fl0m0/AA_Battery_Pack/doc/IBN_RevA.md

# Stücklistenänderungen

1. R5 = 20k
1. R1 = 20k

# Thermokamera

Tests mit 1800 mAh Lipo durchgeführt.

## Last

Vbat = 3,9 V

Last 500 mA und 700 mA

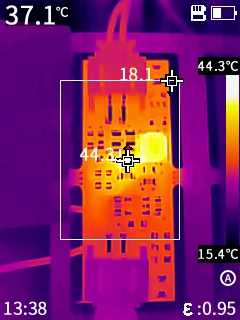
[picture p1: doc/thermal/IRI_20250215_133806.jpg]
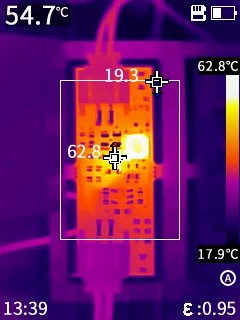
[picture p2: doc/thermal/IRI_20250215_133919.jpg]
 

## Ladebetrieb

Vbat = 3,9 V, R2 = 2k, Ladestrom 0,5 A

VBUS = 5 V, rechts mit zusätzlichem Laststrom 0,5 A

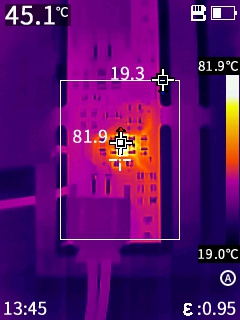
[picture p3: doc/thermal/IRI_20250215_134541.jpg]
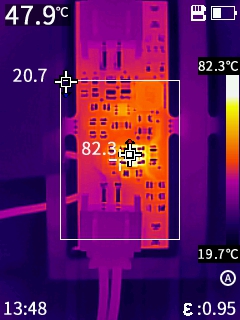
[picture p4: doc/thermal/IRI_20250215_134801.jpg]
  

---

Vbat = 3,9 V, **R2 = 2,2k**, Ladestrom 0,454 mA

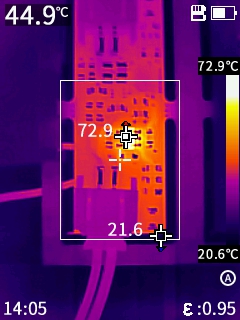
[picture p5: doc/thermal/IRI_20250215_140542.jpg]
 

---

Vbat = 3,9 V, **R2 = 3k**, Ladestrom 0,333 mA

VBUS = 5 V, rechts VBUS = 5,4 V

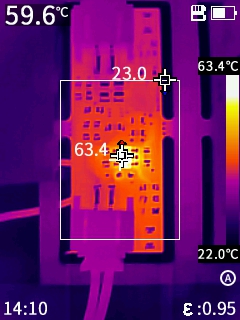
[picture p6: doc/thermal/IRI_20250215_141036.jpg]
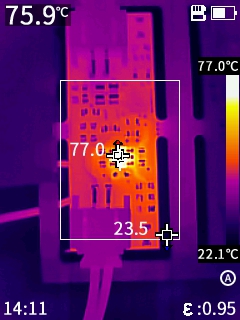
[picture p7: doc/thermal/IRI_20250215_141140.jpg]
 

---

# Verbrauch im Leerlauf

| Vbat (V) | Ibat (µA) | Low Bat LED |
| --- | --- | --- |
| 3,2 | 821 | an |
| 3,3 | 807 | an |
| 3,4 | 794 | an |
| 3,5 | 782 | an |
| 3,6 | 772 | an |
| 3,7 | 663 | aus |
| 3,8 | 649 | aus |
| 3,9 | 636 | aus |
| 4,0 | 623 | aus |
| 4,1 | 613 | aus |
| 4,2 | 601 | aus |
