fl0m0/AA_Battery_Pack/doc/thermal/VIS_20250215_134541.jpg

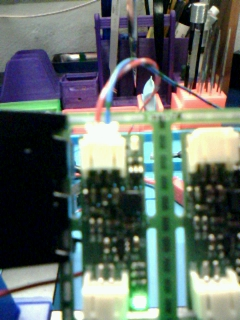
doc/thermal/VIS_20250215_134541.jpg
