fl0m0/AA_Battery_Pack/mech/Triple_AA.FCStd

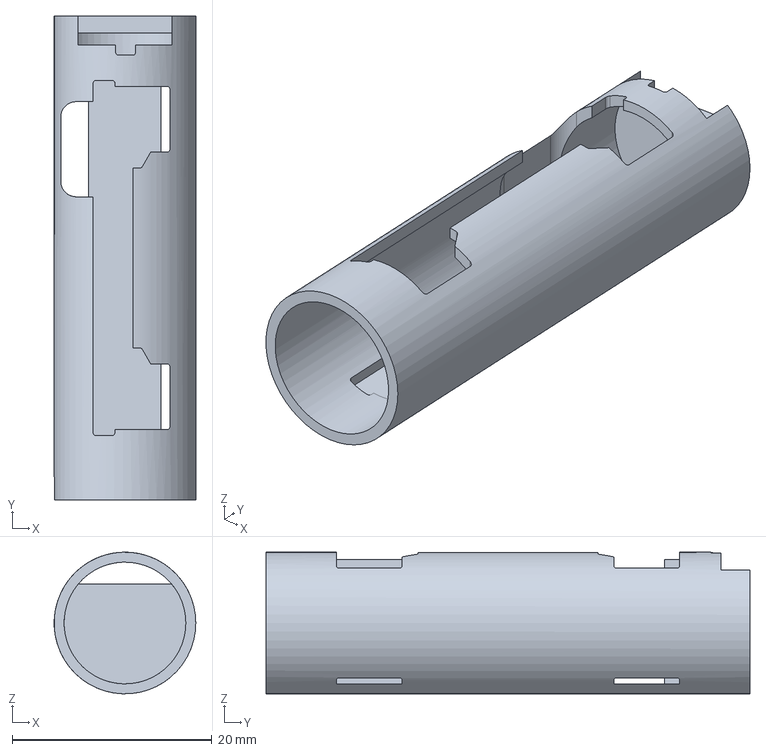
[picture p16: CAD file, 2025-02-15]
mech/Triple_AA.FCStd
14.2 x 48.5 x 14.2 mm
