fl0m0/AA_Battery_Pack/mech/Keystone_228.step

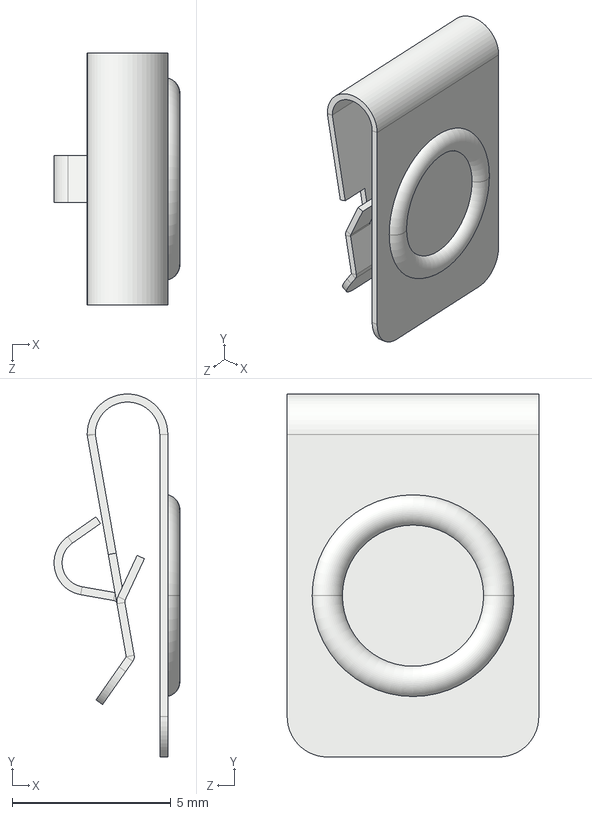
[picture p17: CAD file, 2025-02-15]
mech/Keystone_228.step
3.96 x 11.4 x 7.92 mm
