fl0m0/AA_Battery_Pack/mech/Keystone_209.step

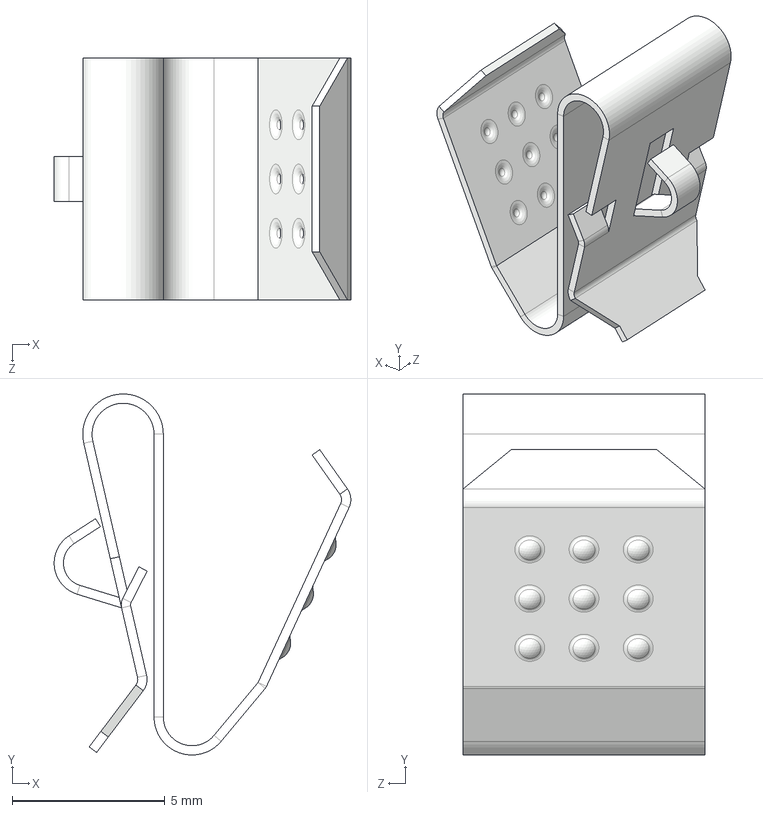
[picture p18: CAD file, 2025-02-15]
mech/Keystone_209.step
9.73 x 11.8 x 7.92 mm
