fl0m0/AA_Battery_Pack/mech/PCBA.FCStd

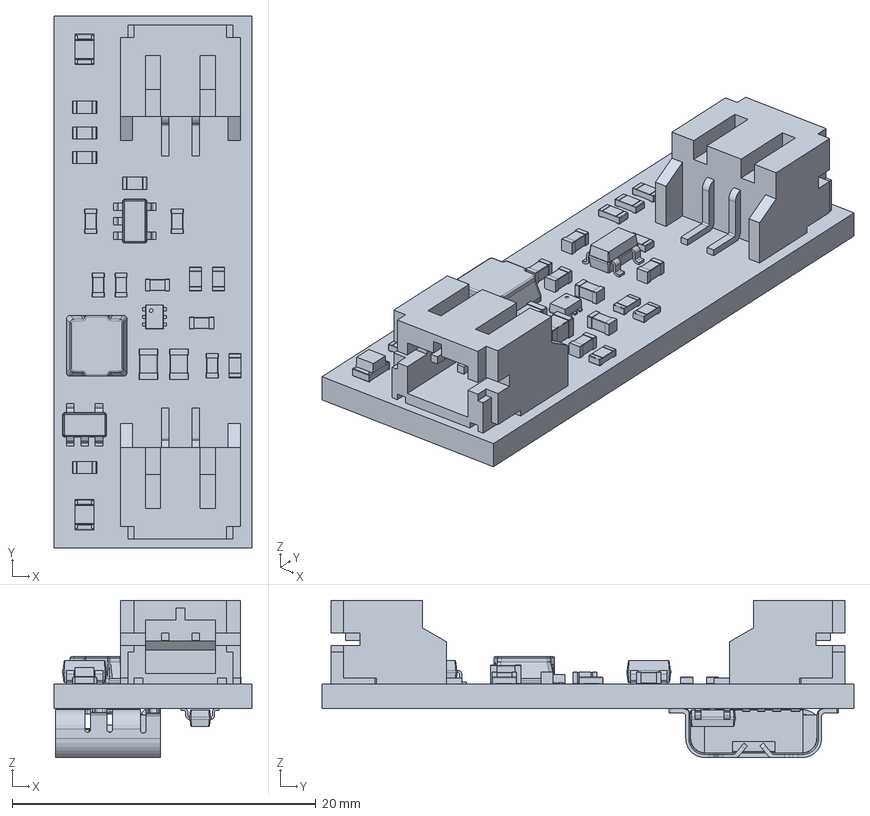
[picture p19: CAD file, 2025-02-15]
mech/PCBA.FCStd
13.0 x 35.0 x 10.3 mm
