fl0m0/AA_Battery_Pack/pcb/TripleAA/outputs/TripleAA_Rev_A.pdf

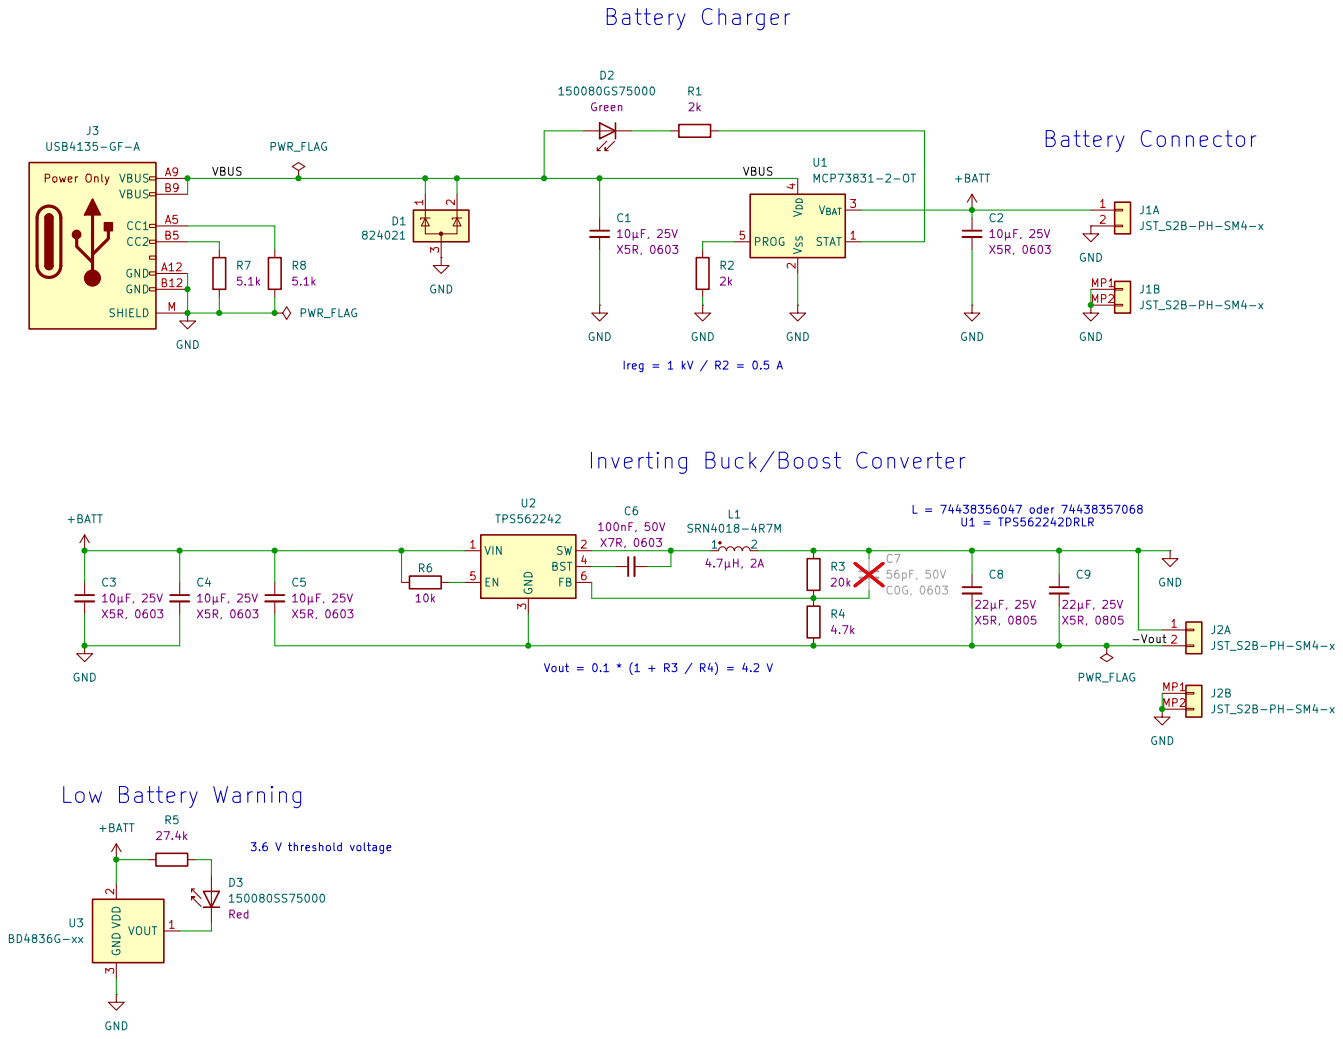
[picture p20: page 1]
