fl0m0/AA_Battery_Pack/pcb/TripleAA/TripleAA.kicad_pcb

## KiCad design pcb/TripleAA/TripleAA.kicad_pcb (2024-12-01)

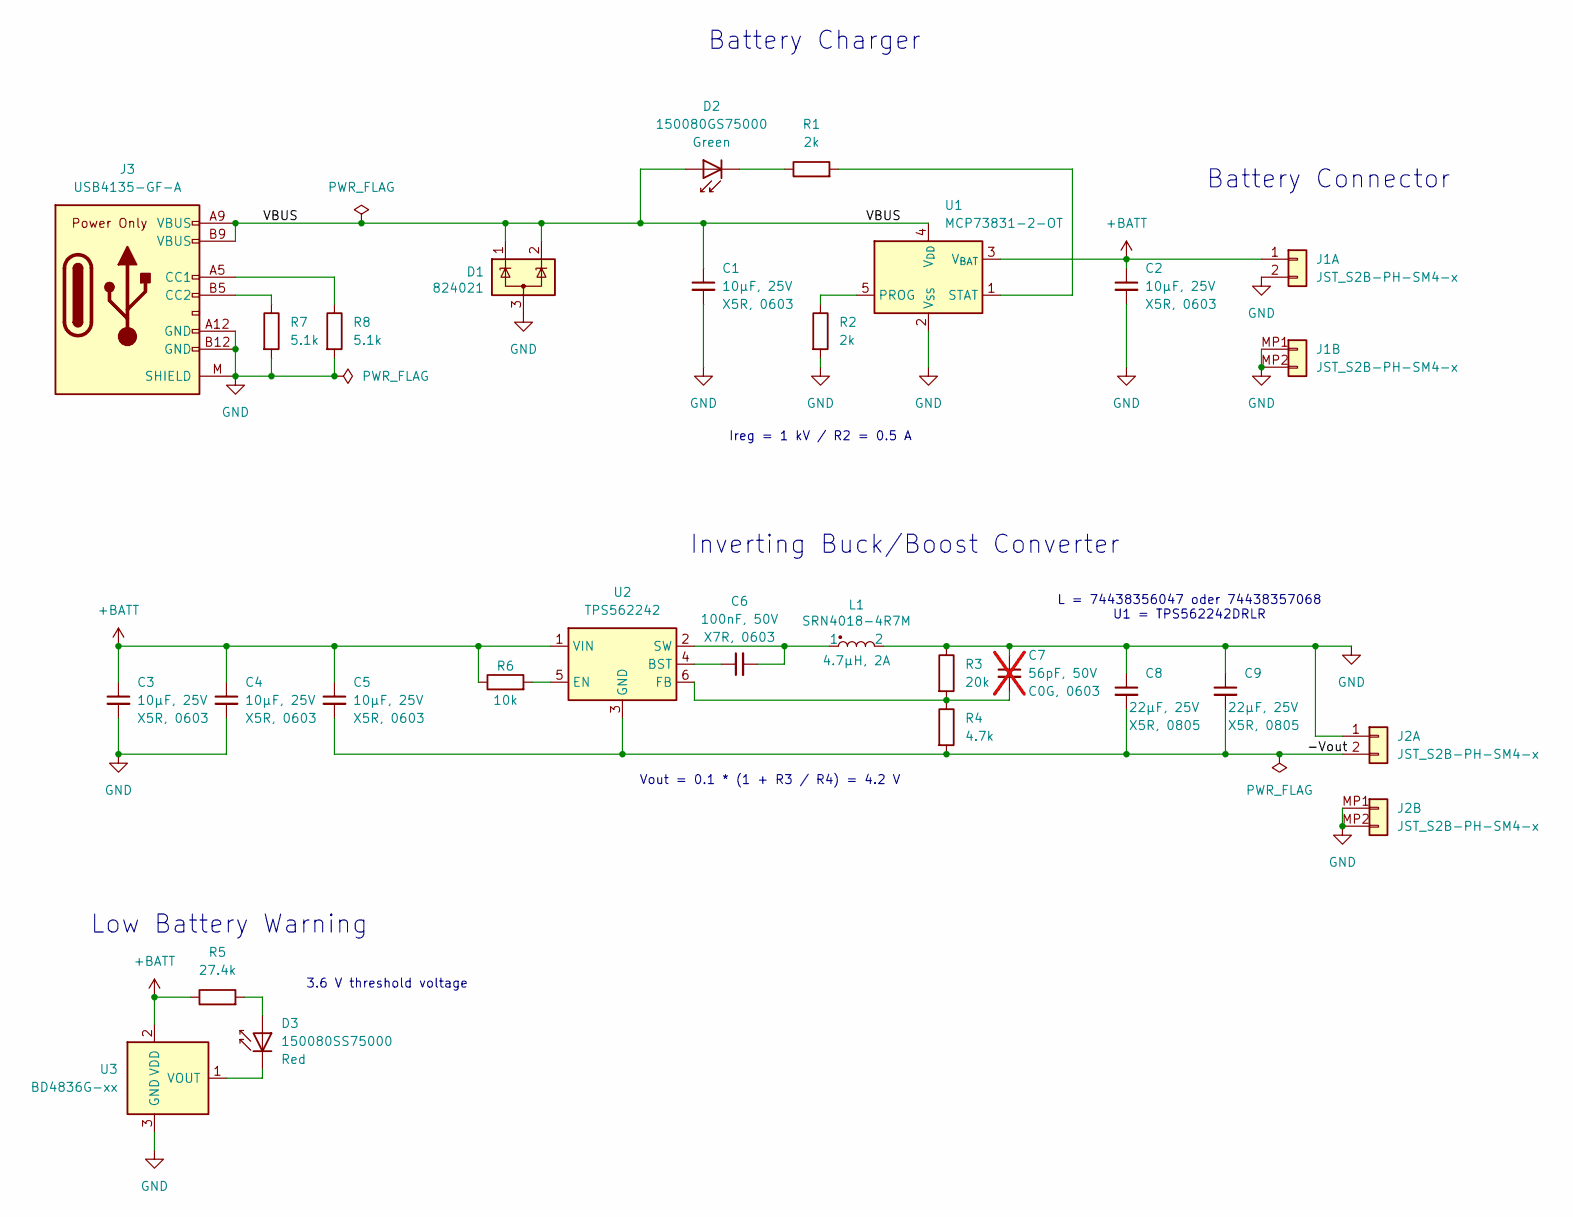
[picture p21: schematic TripleAA.kicad_sch, AA Battery Pack Replacement]

Parts:
C1, C2, C3, C4, C5: 10uF,25V,X5R,0603; C_0603_1608Metric_Pad1.08x0.95mm_HandSolder
C6: 100nF,50V,X7R,0603; C_0603_1608Metric_Pad1.08x0.95mm_HandSolder
C7: 56pF,50V,C0G,0603; C_0603_1608Metric_Pad1.08x0.95mm_HandSolder; not fitted
C8, C9: 22uF,25V,X5R,0805; C_0805_2012Metric_Pad1.18x1.45mm_HandSolder
D1: 824021; SOT-23_Handsoldering
D2: 150080GS75000; LED_0805_2012Metric_Pad1.15x1.40mm_HandSolder
D3: 150080SS75000; LED_0805_2012Metric_Pad1.15x1.40mm_HandSolder
J1, J2: JST_S2B-PH-SM4-x; JST_PH_S2B-PH-SM4-TB_1x02-1MP_P2.00mm_Horizontal; MPN S2B-PH-SM4-TB
J3: USB4135-GF-A; USB-C_Receptacle_GTC_USB4135-GF-A; MPN USB4135-GF-A
L1: SRN4018-4R7M; L_Bourns-SRN4018; MPN SRN4018-4R7M
R1, R2: 2k,0603; R_0603_1608Metric_Pad0.98x0.95mm_HandSolder; Tolerance 1%
R3: 20k,0603; R_0603_1608Metric_Pad0.98x0.95mm_HandSolder; Tolerance 1%
R4: 4.7k,0603; R_0603_1608Metric_Pad0.98x0.95mm_HandSolder; Tolerance 1%
R5: 27.4k,0603; R_0603_1608Metric_Pad0.98x0.95mm_HandSolder; Tolerance 1%
R6: 10k,0603; R_0603_1608Metric_Pad0.98x0.95mm_HandSolder; Tolerance 1%
R7, R8: 5.1k,0603; R_0603_1608Metric_Pad0.98x0.95mm_HandSolder; Tolerance 1%
U1: MCP73831-2-OT; SOT-23-5
U2: TPS562242; SOT-563; MPN TPS562242DRLR
U3: BD4836G-xx; SOT-23-5; MPN BD4836G-xx

Connections:
+BATT: C2.1, C3.1, C4.1, C5.1, J1.1, R5.1, R6.1, U1.3 (V_{BAT}), U2.1 (VIN), U3.2 (VDD)
/-Vout: C5.2, C8.2, C9.2, J2.2, R4.2, U2.3 (GND)
/VBUS: C1.1, D1.1 (K), D1.2 (K), D2.2 (A), J3.A9 (VBUS), J3.B9 (VBUS), U1.4 (V_{DD})
GND: C1.2, C2.2, C3.2, C4.2, C7.1, C8.1, C9.1, D1.3 (A), J1.2, J1.MP1 (MP), J1.MP2 (MP), J2.1, J2.MP1 (MP), J2.MP2 (MP), J3.A12 (GND), J3.B12 (GND), J3.M (SHIELD), L1.2, R2.2, R3.1, R7.2, R8.2, U1.2 (V_{SS}), U3.3 (GND)
unnamed: D2.1 (K), R1.1
unnamed: D3.2 (A), R5.2
unnamed: D3.1 (K), U3.1 (VOUT)
unnamed: J3.A5 (CC1), R8.1
unnamed: J3.B5 (CC2), R7.1
unnamed: R2.1, U1.5 (PROG)
unnamed: R1.2, U1.1 (STAT)
unnamed: C6.1, U2.4 (BST)
unnamed: R6.2, U2.5 (EN)
unnamed: C7.2, R3.2, R4.1, U2.6 (FB)
unnamed: C6.2, L1.1, U2.2 (SW)

Notes on the sheet:
Vout = 0.1 * (1 + R3 / R4) = 4.2 V
Battery Connector
Ireg = 1 kV / R2 = 0.5 A
L = 74438356047 oder 74438357068 U1 = TPS562242DRLR
Inverting Buck/Boost Converter
3.6 V threshold voltage
Battery Charger
Low Battery Warning

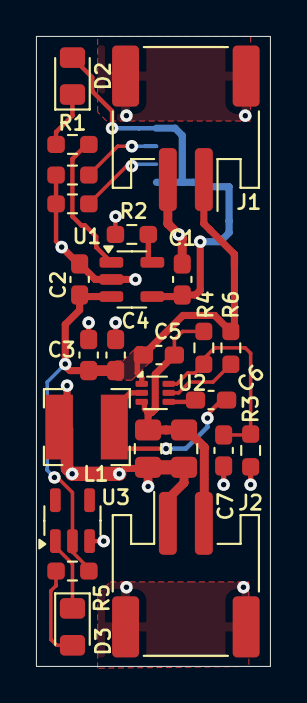
[picture p22: board TripleAA.kicad_pcb from above]

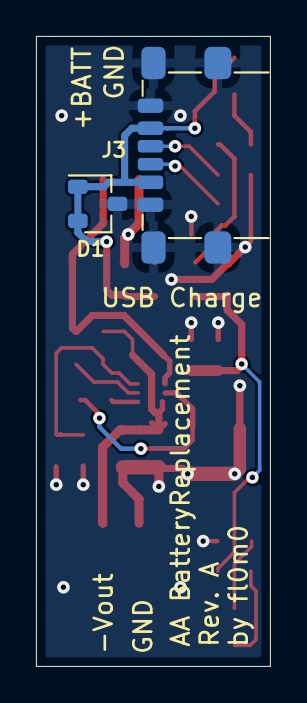
[picture p23: board TripleAA.kicad_pcb from below]

Board: 2 copper layers, 13.0 x 35.0 mm, 27 parts (2 on the bottom side), 15 nets.
