fl0m0/AA_Battery_Pack/(commit log)

2024-11-11 Add components
    [TripleAA.kicad_pcb, TripleAA.kicad_sch]
2024-11-13 Update SCH and PCB
    [PCBA.FCStd, TripleAA.kicad_pcb, TripleAA.kicad_sch, Triple_AA.FCStd]
2024-11-29 Finalize PCB layout
    [PCBA.FCStd, TripleAA.kicad_pcb, TripleAA.kicad_sch, Triple_AA.FCStd]
2024-11-30 Add USB connector
    [TripleAA.kicad_pcb, TripleAA.kicad_sch]
2025-02-15 Update mechanics
    [Keystone_209.step, Keystone_228.step, PCBA.FCStd, Triple_AA.FCStd]
